explora26/tablet_sensor_board/power_button/docs/pcb_3d_iso.png

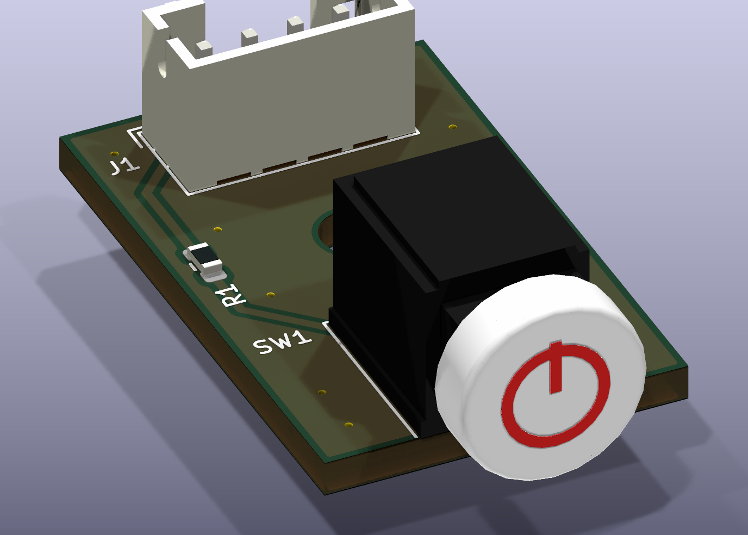
power_button/docs/pcb_3d_iso.png
