explora26/tablet_sensor_board/power_button/docs/pcb_3d_top.png

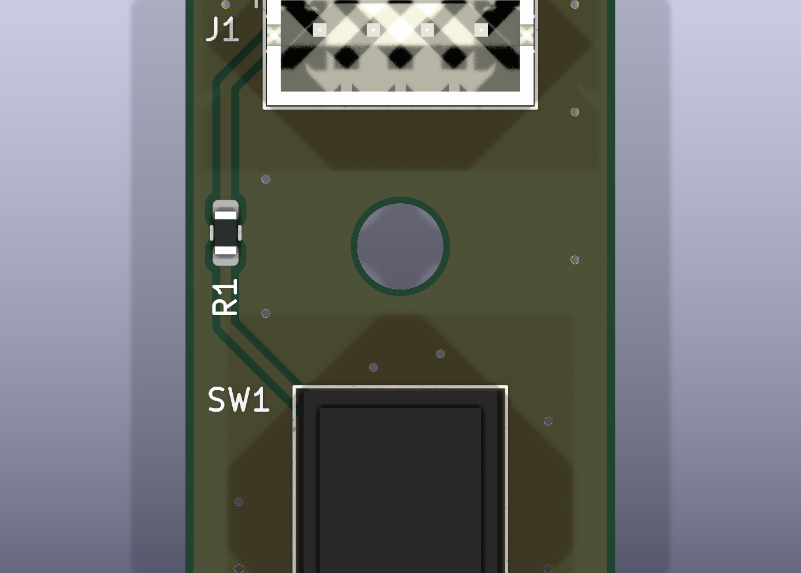
power_button/docs/pcb_3d_top.png
