explora26/tablet_sensor_board/docs/pcb_front.png

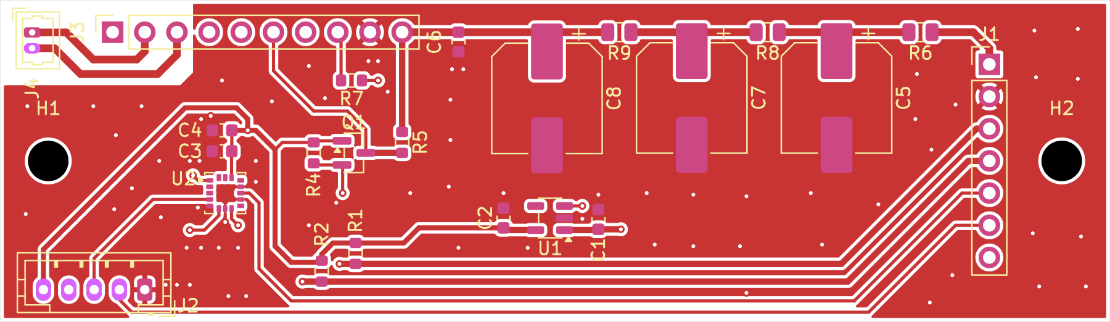
docs/pcb_front.png
