explora26/tablet_sensor_board/fab/bom.csv

Designator | Qty | Value | Package | Manufacturer | MPN | LCSC | Assembly | Status | Notes
U2 | 1 | LIS3DH | LGA-16 3x3mm | ST | LIS3DHTR | C15134 | SMT | confirmed | 3-axis accelerometer (I2C addr 0x18)
U1 | 1 | TLV75530 | SOT-23-5 | TI | TLV75530PDBVR | C507268 | SMT | confirmed | 500mA LDO 3.0V
Q1 | 1 | BSS138 | SOT-23 | Diodes | BSS138-7-F | C40912 | SMT | confirmed | RFID TX level shifter
C5 C7 C8 | 3 | 1000uF 10V | SMD 8x10.2mm | Panasonic | EEE-FT1A102AP | C278408 | SMT | confirmed | RFID supply RC filter; polarized
C1 C2 | 2 | 1uF 16V X7R | 0603 | YAGEO | CC0603KRX7R7BB105 | C106248 | SMT | confirmed | LDO input/output
C3 C6 | 2 | 100nF 50V X7R | 0603 | YAGEO | CC0603KRX7R9BB104 | C14663 | SMT | confirmed | LIS3DH VDD / RFID HF decoupling
C4 | 1 | 10uF 10V X5R | 0603 | Samsung | CL10A106KP8NNNC | C19702 | SMT | confirmed | LIS3DH bulk; JLC basic part
R1 R2 | 2 | 4.7k 1% | 0603 | YAGEO | RC0603FR-074K7L | C99782 | SMT | confirmed | I2C pull-ups to 3.0V
R4 R5 R7 | 3 | 10k 1% | 0603 | YAGEO | RC0603FR-0710KL | C98220 | SMT | confirmed | Level shifter pull-ups / WL-125 RESET pull-up
R6 | 1 | 4.7R | 0805 | YAGEO | (per LCSC C137423) | C137423 | SMT | user-selected | RFID RC filter stage 1; verify the LCSC page shows 4.7 ohm
R8 R9 | 2 | 1R | 0805 | YAGEO | (per LCSC C131397) | C131397 | SMT | user-selected | RFID RC filter stages 2-3; verify the LCSC page shows 1 ohm
J2 | 1 | JST PH 5P vertical | 2.0mm THT | JST | B5B-PH-K-S(LF)(SN) | C157993 | hand solder | confirmed | BQ25798 charger board
J1 | 1 | 1x07 pin header | 2.54mm THT | any |  |  | hand solder |  | NanoPC-T4 interface
J3 | 1 | 1x10 pin socket | 2.54mm THT | any |  |  | hand solder |  | WL-125 socket (pin 1 = key)
J4 | 1 | PicoBlade 2P vertical | 1.25mm THT | Molex | 53047-0210 |  | hand solder | find LCSC | RFID antenna coil
