explora26/tablet_sensor_board/power_button/3d/power_button_board.step

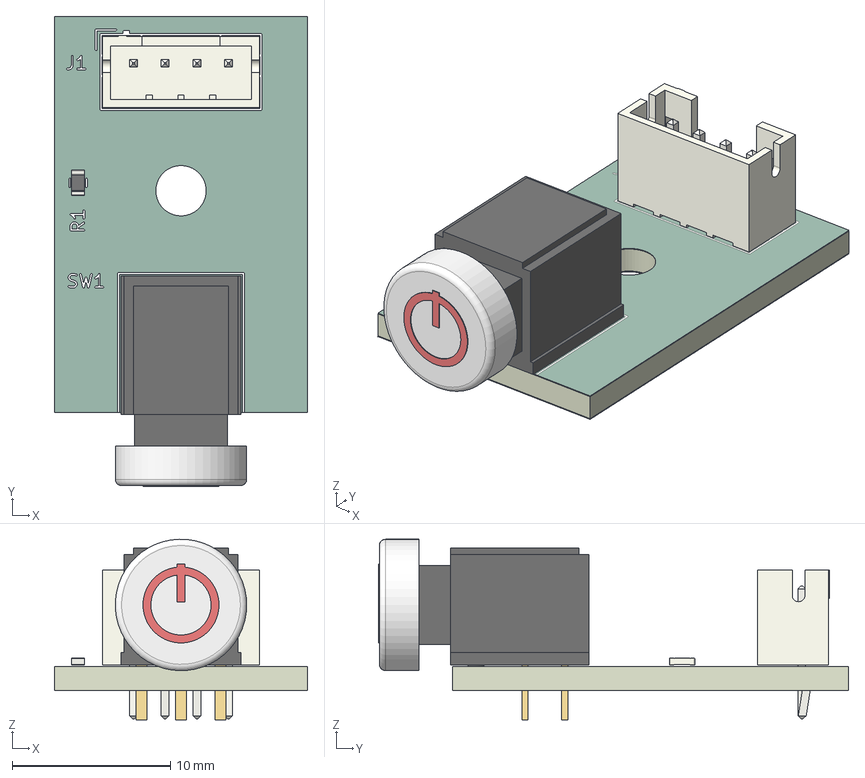
[picture p4: CAD file, 2026-10-19]
power_button/3d/power_button_board.step
16.0 x 29.7 x 11.4 mm
housing
cap
symbol
pins
R_0603_1608Metric
JST_B4B_PH_K
power_button_silkscreen x 2
power_button_soldermask x 2
power_button_PCB
