explora26/tablet_sensor_board/power_button/3d/KRHRO_K6-6277D.step

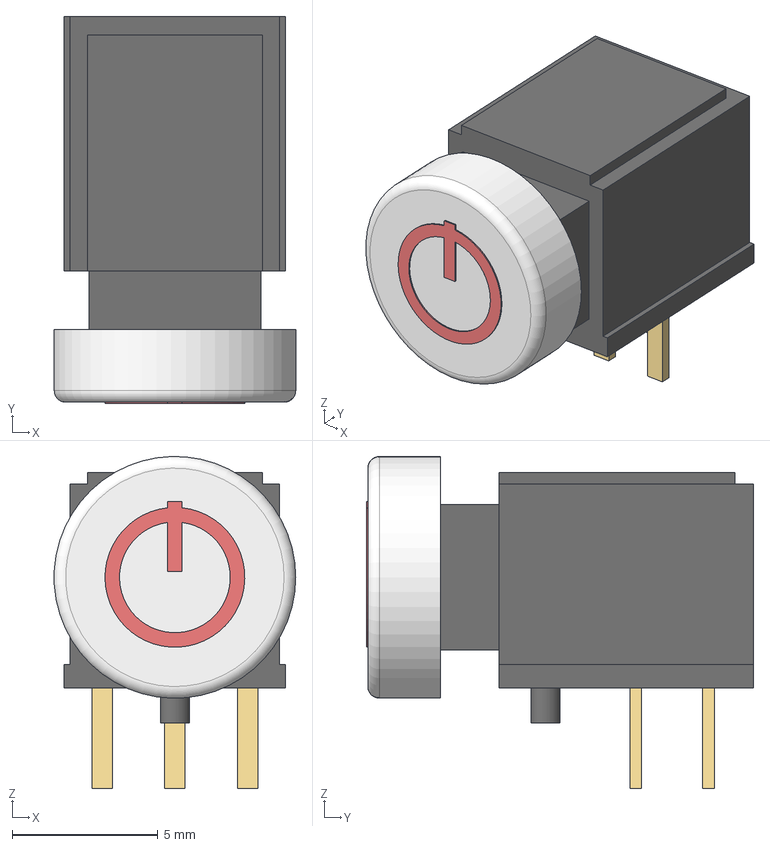
[picture p5: CAD file, 2026-10-19]
power_button/3d/KRHRO_K6-6277D.step
8.29 x 13.3 x 11.4 mm
housing
cap
symbol
pins
