explora26/tablet_sensor_board/docs/schematic.pdf

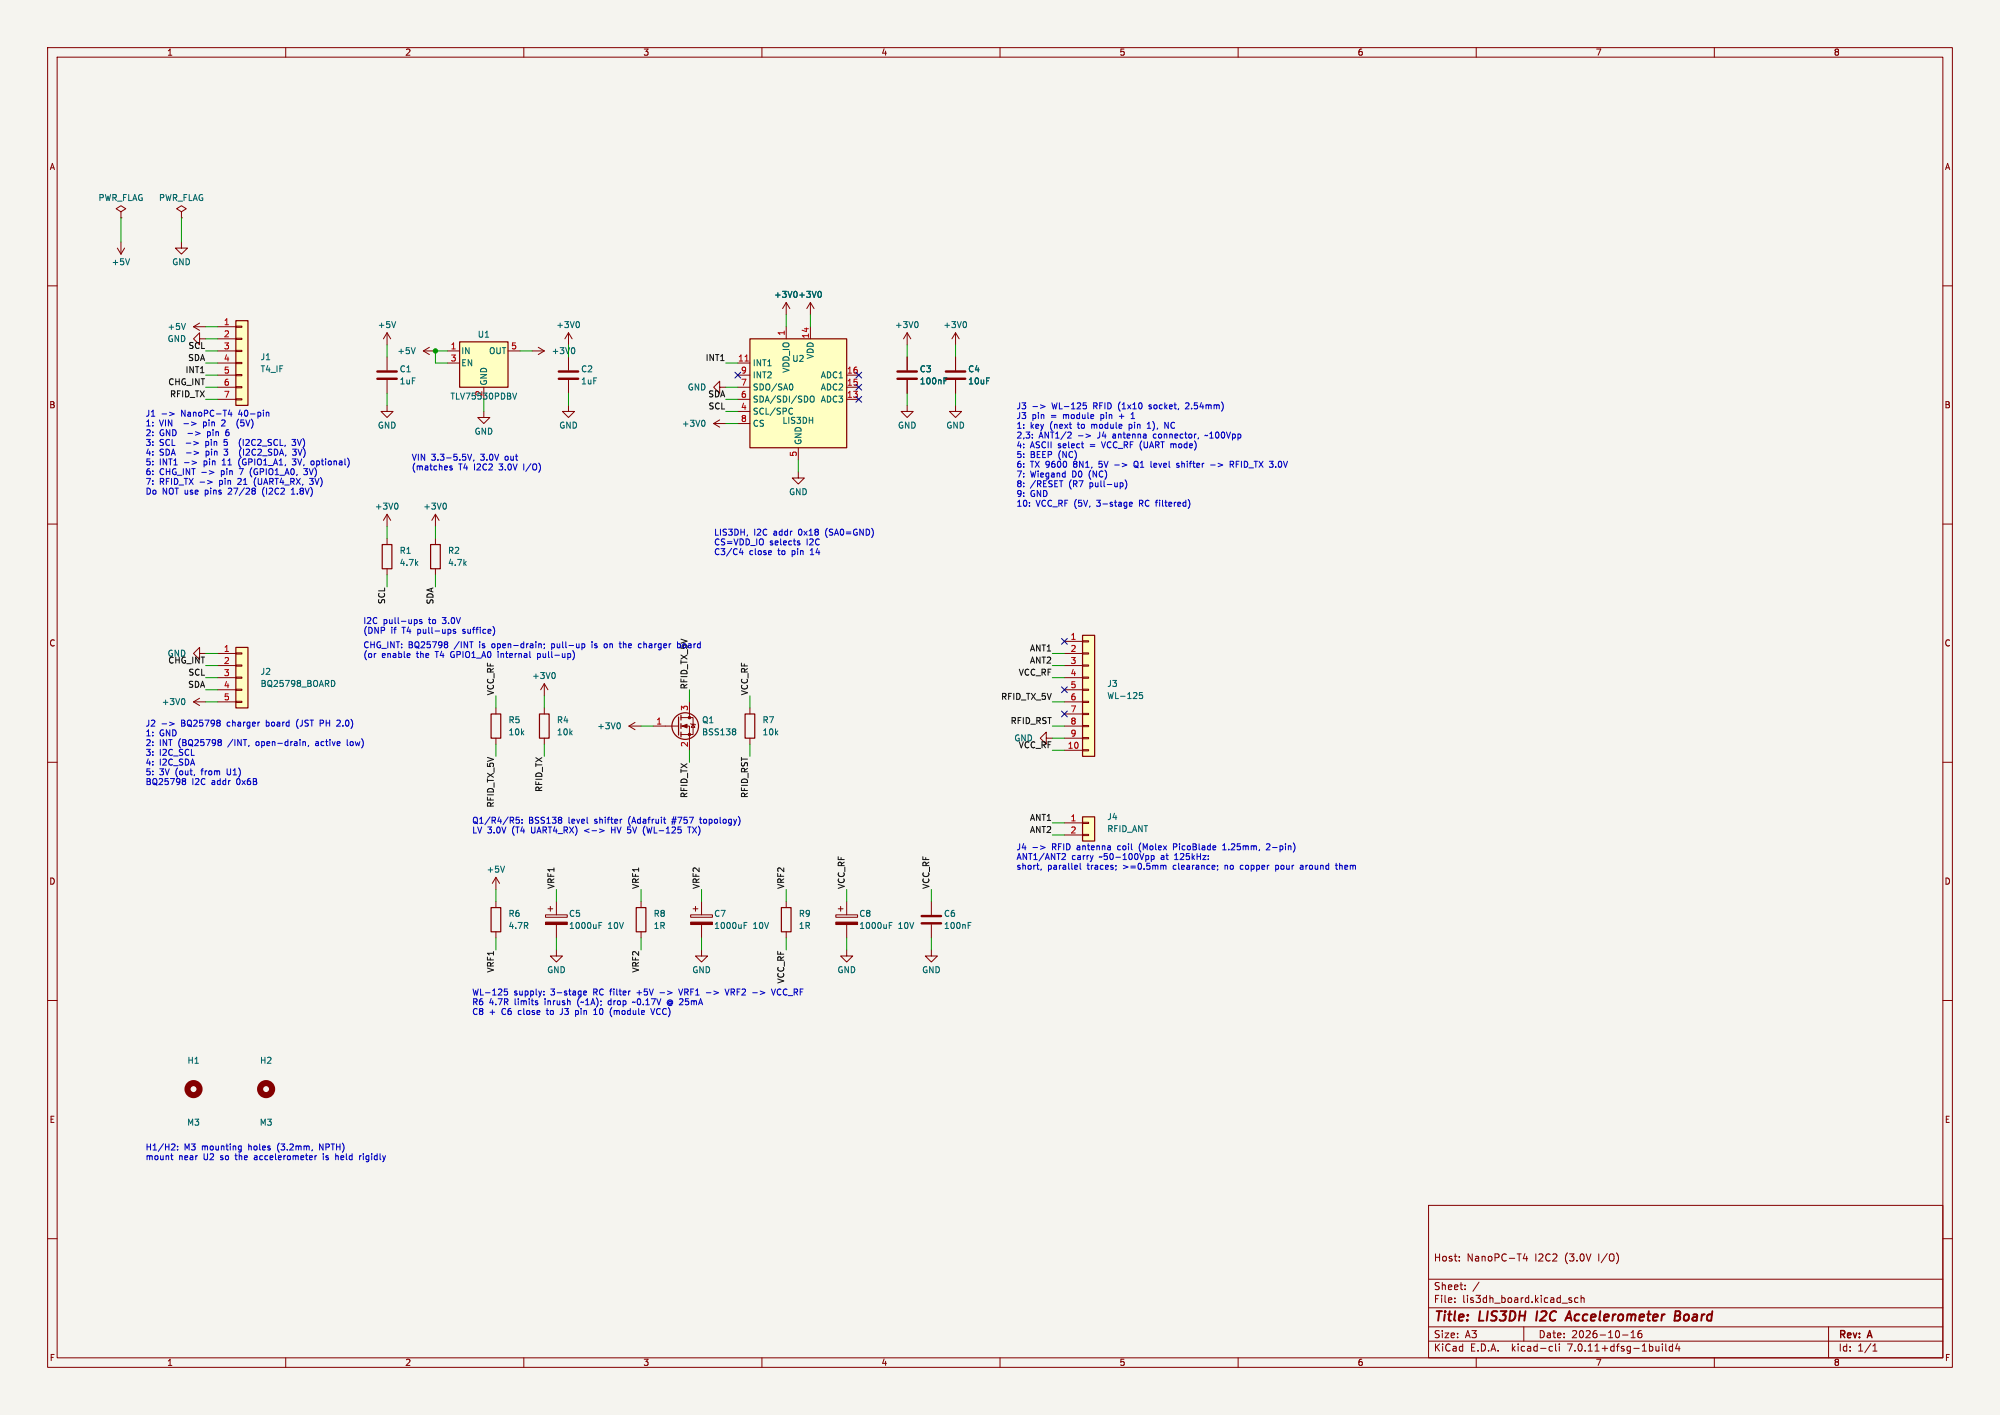
[picture p6: page 1]

2 EN 3 OUT 5 U1 TLV75530PDBV GND GND GND GND

5 SDA/SDI/SDO 6 SDO/SA0 7 CS 8
LIS3DH GND

1: key (next to module pin 1), NC

7: Wiegand D0 (NC) 8: /RESET (R7 pull-up) 9: GND

Id: 1/1 Title: LIS3DH I2C Accelerometer Board
