explora26/tablet_sensor_board/power_button/docs/schematic.pdf

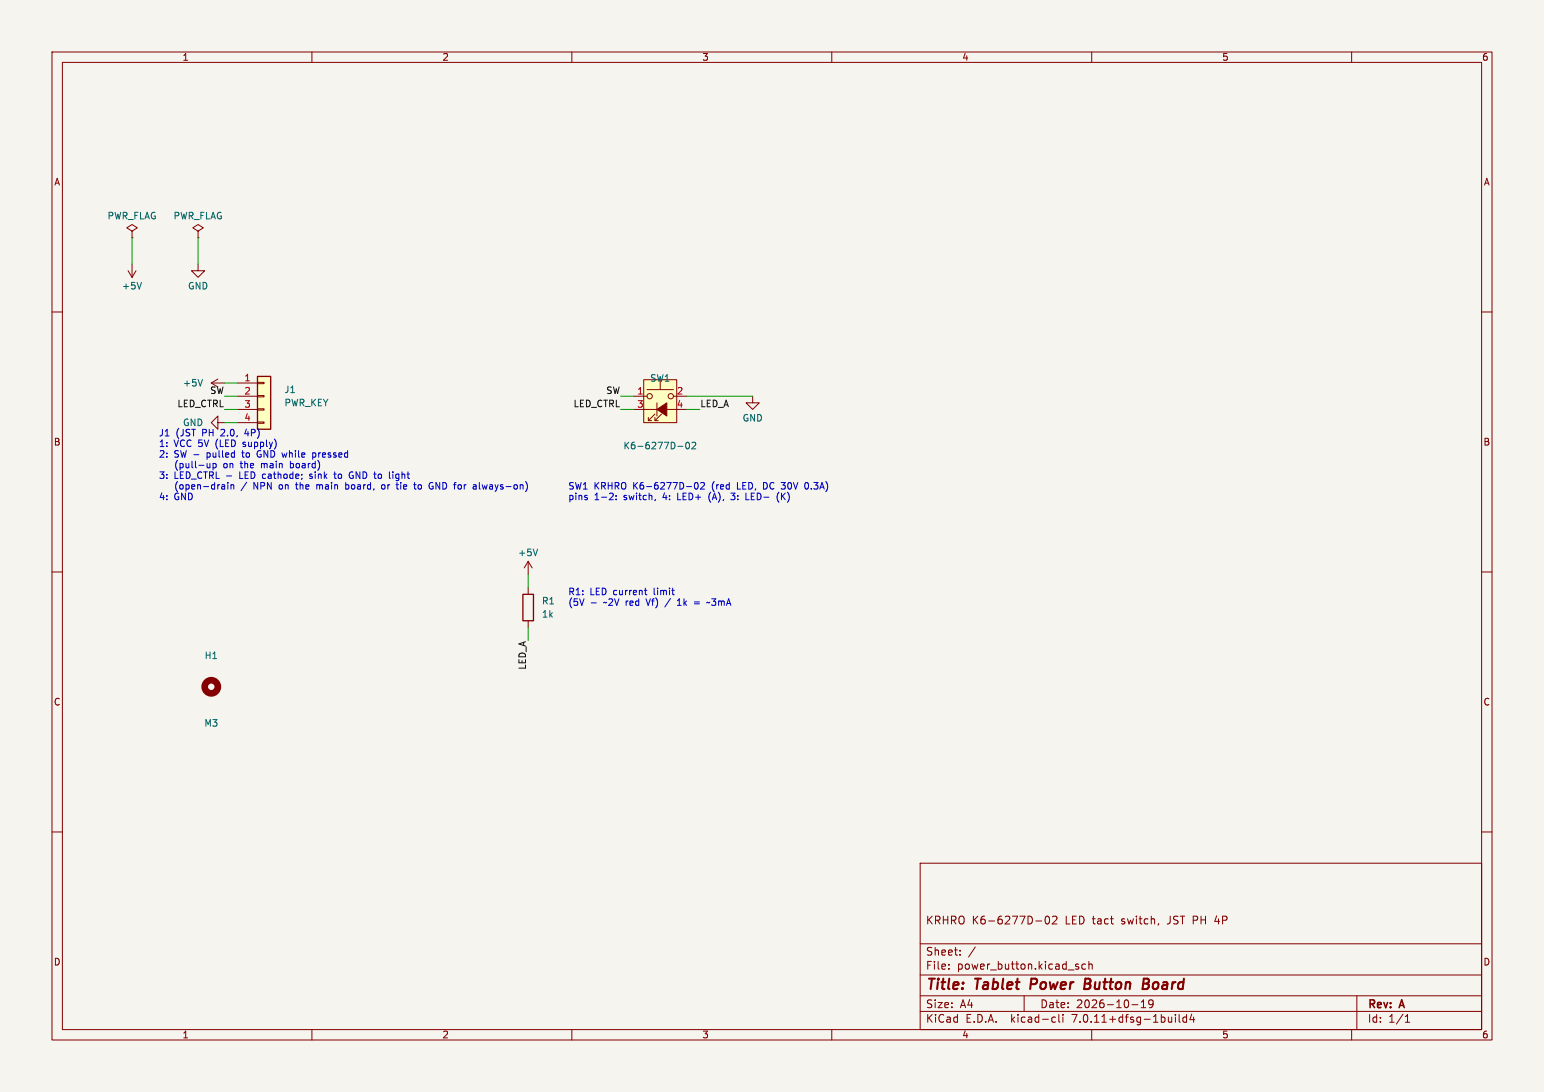
[picture p7: page 1]

H1 M3 GND
J1 (JST PH 2.0, 4P) 1: VCC 5V (LED supply) 2: SW - pulled to GND while pressed

R1: LED current limit (5V - ~2V red Vf) / 1k = ~3mA

Id: 1/1 Title: Tablet Power Button Board
