explora26/tablet_sensor_board/power_button/power_button.kicad_pcb

## KiCad design power_button/power_button.kicad_pcb (2026-10-19)

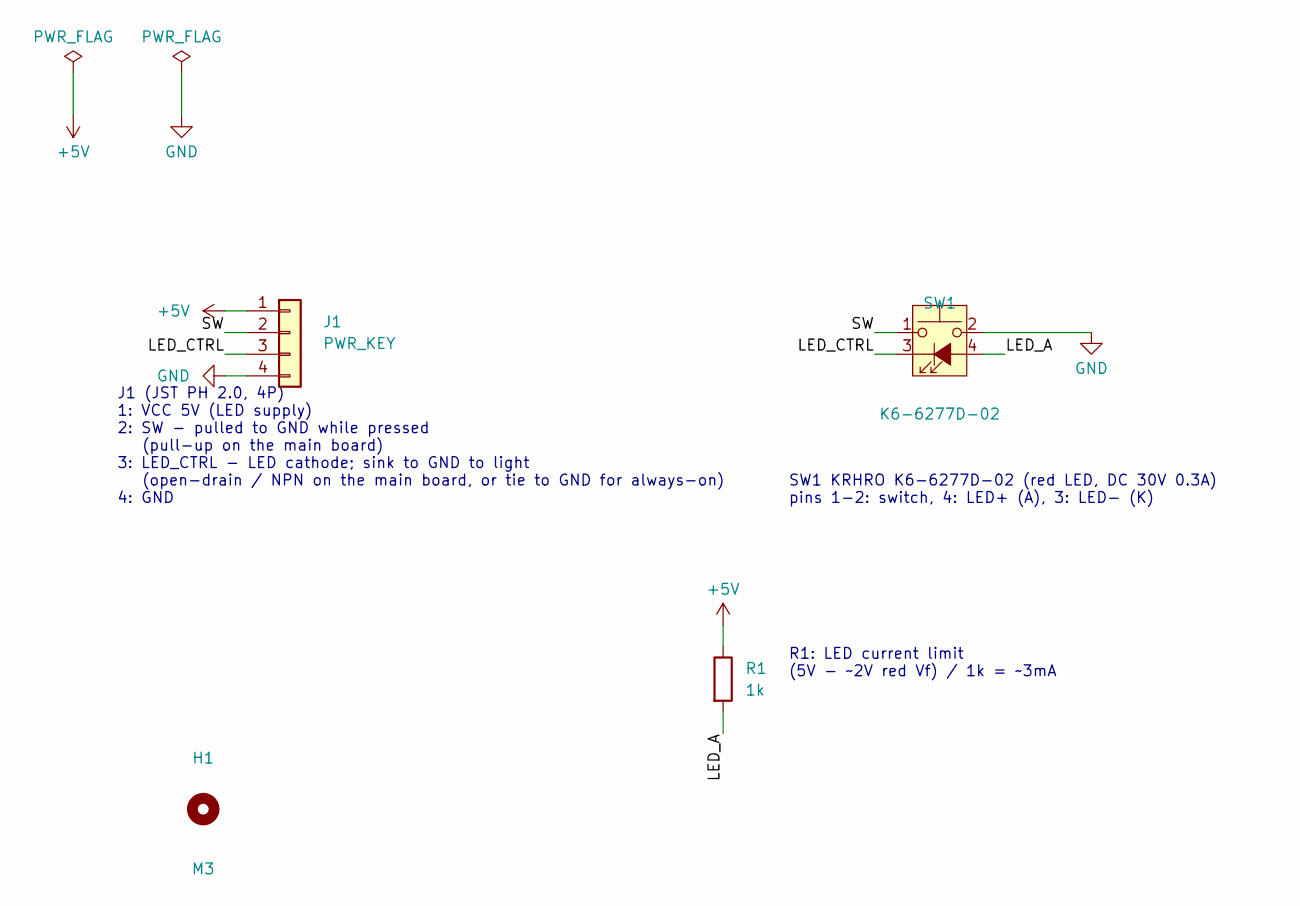
[picture p8: schematic power_button.kicad_sch, Tablet Power Button Board]

Parts:
H1: M3; MountingHole_3.2mm_M3
J1: PWR_KEY; JST_PH_B4B-PH-K_1x04_P2.00mm_Vertical; MPN JST B4B-PH-K-S(LF)(SN)
R1: 1k; R_0603_1608Metric; MPN YAGEO RC0603FR-071KL
SW1: K6-6277D-02; KRHRO_K6-6277D; MPN KRHRO K6-6277D-02; LCSC C693836

Connections:
+5V: J1.1, R1.1
/LED_A: R1.2, SW1.4 (A)
/LED_CTRL: J1.3, SW1.3 (K)
/SW: J1.2, SW1.1
GND: J1.4, SW1.2

Notes on the sheet:
J1 (JST PH 2.0, 4P) 1: VCC 5V (LED supply) 2: SW - pulled to GND while pressed (pull-up on the main board) 3: LED_CTRL - LED cathode; sink to GND to light (open-drain / NPN on the main board, or tie to GND for always-on) 4: GND
SW1 KRHRO K6-6277D-02 (red LED, DC 30V 0.3A) pins 1-2: switch, 4: LED+ (A), 3: LED- (K)
R1: LED current limit (5V - ~2V red Vf) / 1k = ~3mA

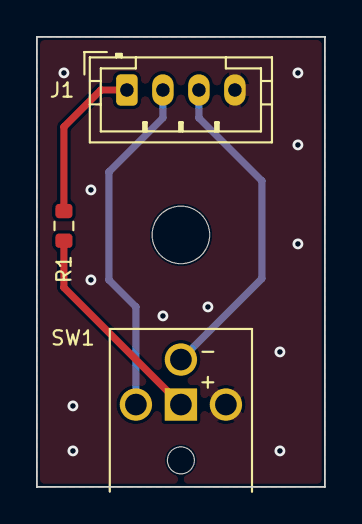
[picture p9: board power_button.kicad_pcb from above]

Board: 2 copper layers, 16.0 x 25.0 mm, 4 parts (0 on the bottom side), 5 nets.
