explora26/tablet_sensor_board/lis3dh_board.kicad_pcb

## KiCad design lis3dh_board.kicad_pcb (2026-10-17)

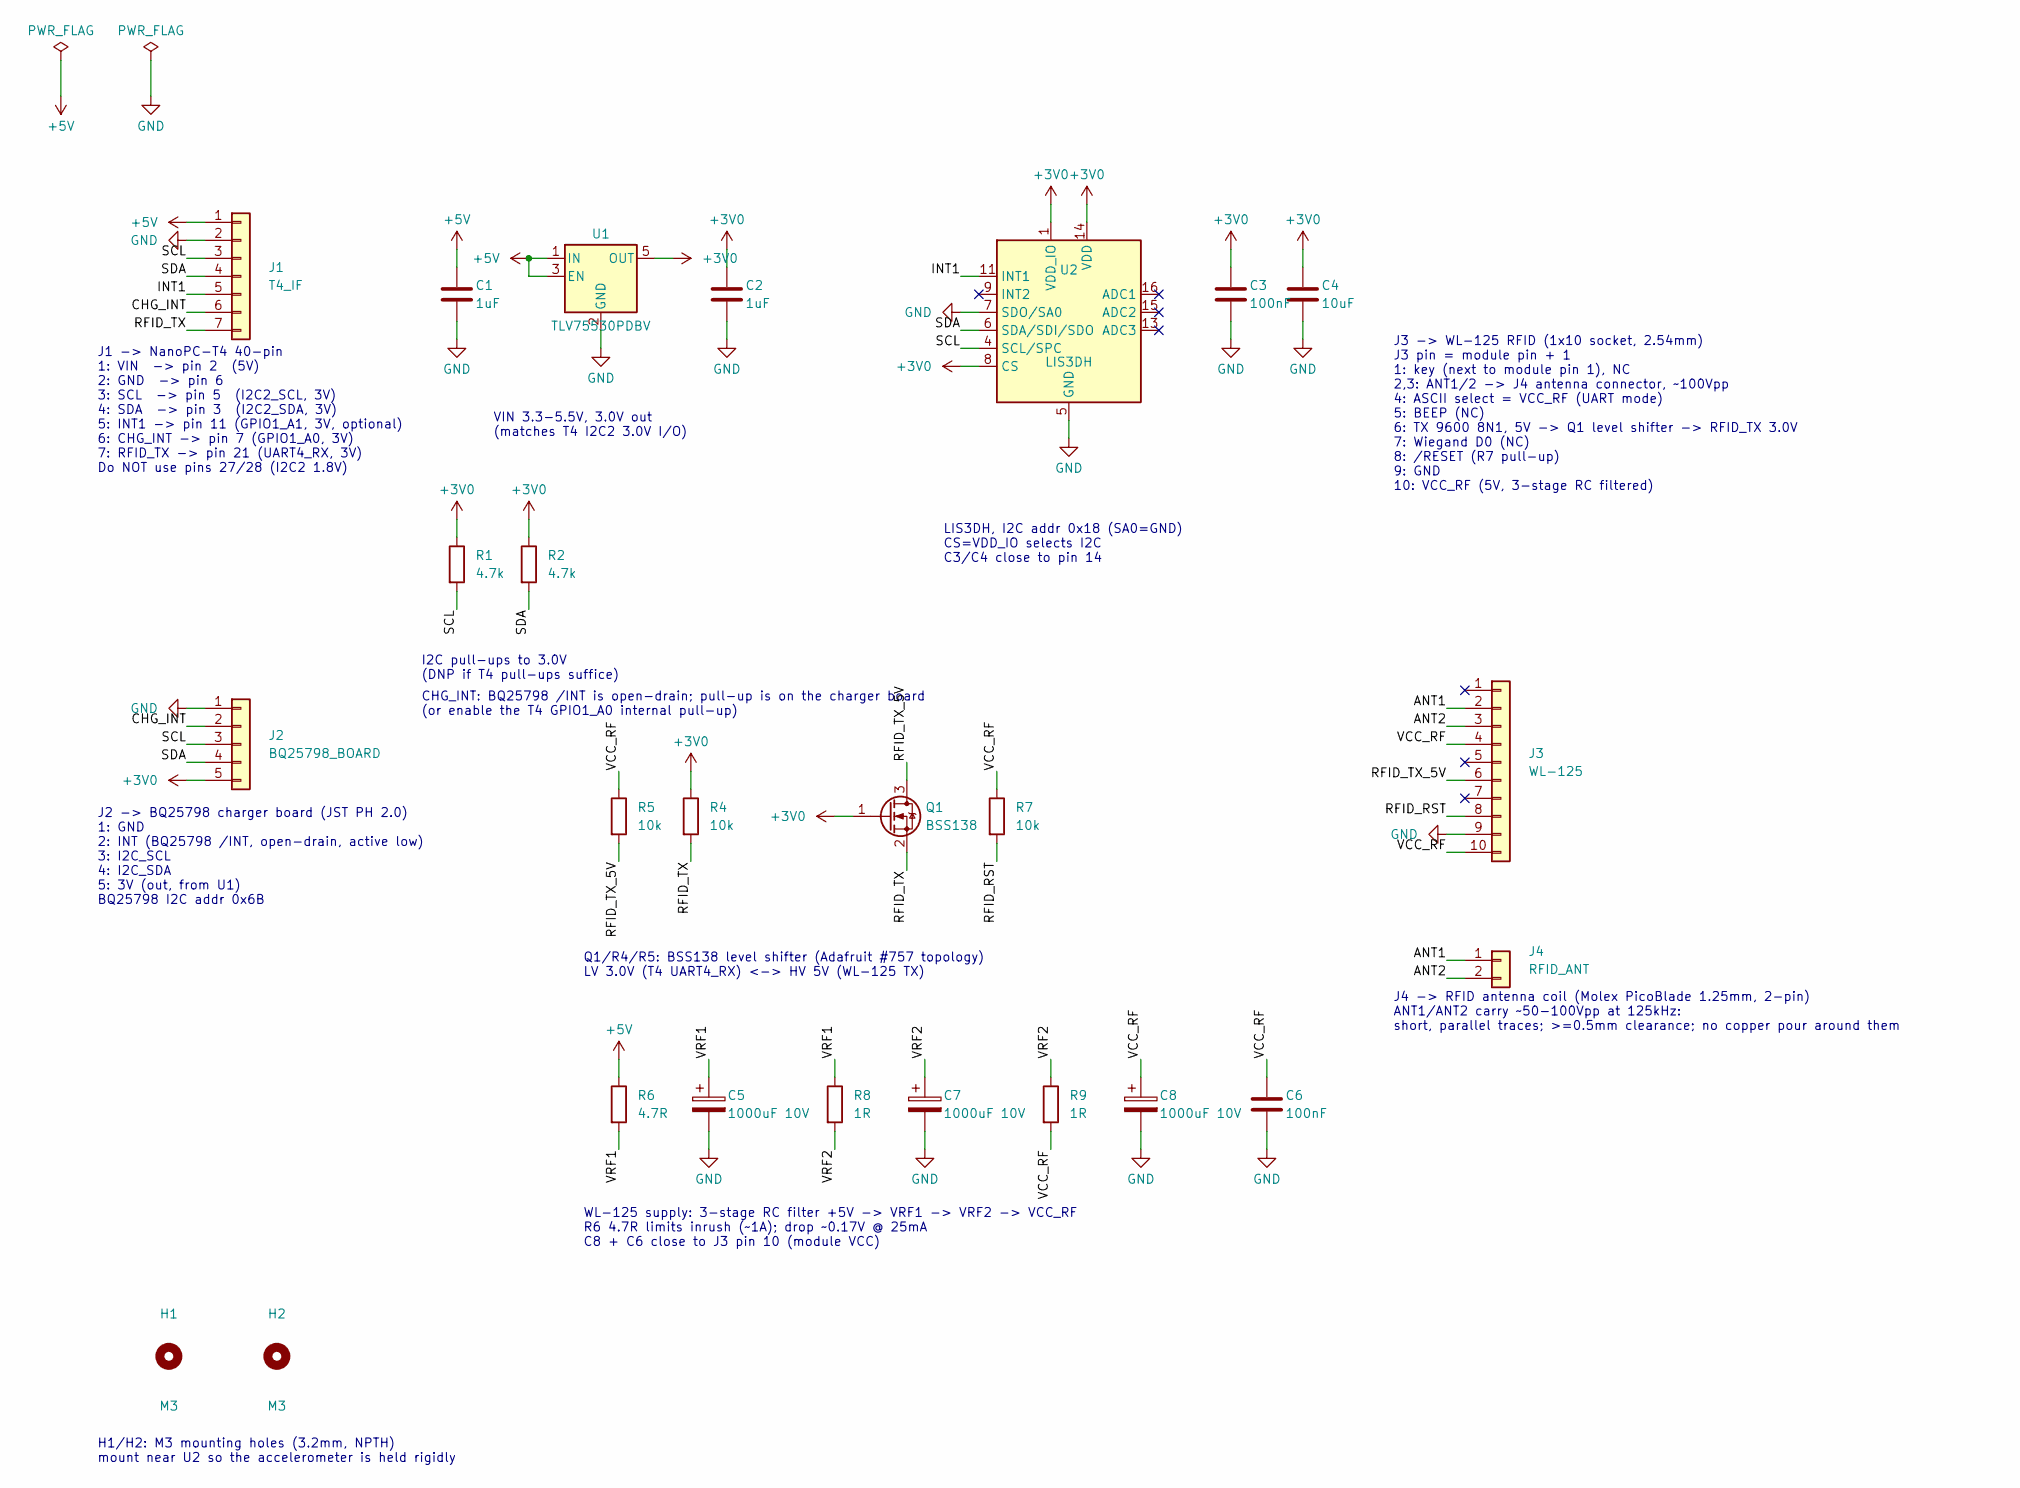
[picture p10: schematic lis3dh_board.kicad_sch, LIS3DH I2C Accelerometer Board]

Parts:
C1, C2: 1uF; C_0603_1608Metric
C3, C6: 100nF; C_0603_1608Metric
C4: 10uF; C_0603_1608Metric
C5, C7, C8: 1000uF 10V; CP_Elec_8x10.5; MPN Panasonic EEE-FT1A102AP; LCSC C278408
H1, H2: M3; MountingHole_3.2mm_M3
J1: T4_IF; PinHeader_1x07_P2.54mm_Vertical
J2: BQ25798_BOARD; JST_PH_B5B-PH-K_1x05_P2.00mm_Vertical
J3: WL-125; PinSocket_1x10_P2.54mm_Vertical
J4: RFID_ANT; Molex_PicoBlade_53047-0210_1x02_P1.25mm_Vertical; MPN Molex 53047-0210
Q1: BSS138; SOT-23
R1, R2: 4.7k; R_0603_1608Metric
R4, R5, R7: 10k; R_0603_1608Metric
R6: 4.7R; R_0805_2012Metric
R8, R9: 1R; R_0805_2012Metric
U1: TLV75530PDBV; SOT-23-5
U2: LIS3DH; LGA-16_3x3mm_P0.5mm_LayoutBorder3x5y

Connections:
+3V0: C2.1, C3.1, C4.1, J2.5, Q1.1 (G), R1.1, R2.1, R4.1, U1.5 (OUT), U2.1 (VDD_IO), U2.8 (CS), U2.14 (VDD)
+5V: C1.1, J1.1, R6.1, U1.1 (IN), U1.3 (EN)
/ANT1: J3.2, J4.1
/ANT2: J3.3, J4.2
/CHG_INT: J1.6, J2.2
/INT1: J1.5, U2.11 (INT1)
/RFID_RST: J3.8, R7.2
/RFID_TX: J1.7, Q1.2 (S), R4.2
/RFID_TX_5V: J3.6, Q1.3 (D), R5.2
/SCL: J1.3, J2.3, R1.2, U2.4 (SCL/SPC)
/SDA: J1.4, J2.4, R2.2, U2.6 (SDA/SDI/SDO)
/VCC_RF: C6.1, C8.1, J3.4, J3.10, R5.1, R7.1, R9.2
/VRF1: C5.1, R6.2, R8.1
/VRF2: C7.1, R8.2, R9.1
GND: C1.2, C2.2, C3.2, C4.2, C5.2, C6.2, C7.2, C8.2, J1.2, J2.1, J3.9, U1.2 (GND), U2.5 (GND), U2.7 (SDO/SA0), U2.10 (GND), U2.12 (GND)

Notes on the sheet:
J1 -> NanoPC-T4 40-pin 1: VIN -> pin 2 (5V) 2: GND -> pin 6 3: SCL -> pin 5 (I2C2_SCL, 3V) 4: SDA -> pin 3 (I2C2_SDA, 3V) 5: INT1 -> pin 11 (GPIO1_A1, 3V, optional) 6: CHG_INT -> pin 7 (GPIO1_A0, 3V) 7: RFID_TX -> pin 21 (UART4_RX, 3V) Do NOT use pins 27/28 (I2C2 1.8V)
VIN 3.3-5.5V, 3.0V out (matches T4 I2C2 3.0V I/O)
I2C pull-ups to 3.0V (DNP if T4 pull-ups suffice)
J2 -> BQ25798 charger board (JST PH 2.0) 1: GND 2: INT (BQ25798 /INT, open-drain, active low) 3: I2C_SCL 4: I2C_SDA 5: 3V (out, from U1) BQ25798 I2C addr 0x6B
CHG_INT: BQ25798 /INT is open-drain; pull-up is on the charger board (or enable the T4 GPIO1_A0 internal pull-up)
J3 -> WL-125 RFID (1x10 socket, 2.54mm) J3 pin = module pin + 1 1: key (next to module pin 1), NC 2,3: ANT1/2 -> J4 antenna connector, ~100Vpp 4: ASCII select = VCC_RF (UART mode) 5: BEEP (NC) 6: TX 9600 8N1, 5V -> Q1 level shifter -> RFID_TX 3.0V 7: Wiegand D0 (NC) 8: /RESET (R7 pull-up) 9: GND 10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
J4 -> RFID antenna coil (Molex PicoBlade 1.25mm, 2-pin) ANT1/ANT2 carry ~50-100Vpp at 125kHz: short, parallel traces; >=0.5mm clearance; no copper pour around them
Q1/R4/R5: BSS138 level shifter (Adafruit #757 topology) LV 3.0V (T4 UART4_RX) <-> HV 5V (WL-125 TX)
WL-125 supply: 3-stage RC filter +5V -> VRF1 -> VRF2 -> VCC_RF R6 4.7R limits inrush (~1A); drop ~0.17V @ 25mA C8 + C6 close to J3 pin 10 (module VCC)
LIS3DH, I2C addr 0x18 (SA0=GND) CS=VDD_IO selects I2C C3/C4 close to pin 14
H1/H2: M3 mounting holes (3.2mm, NPTH) mount near U2 so the accelerometer is held rigidly

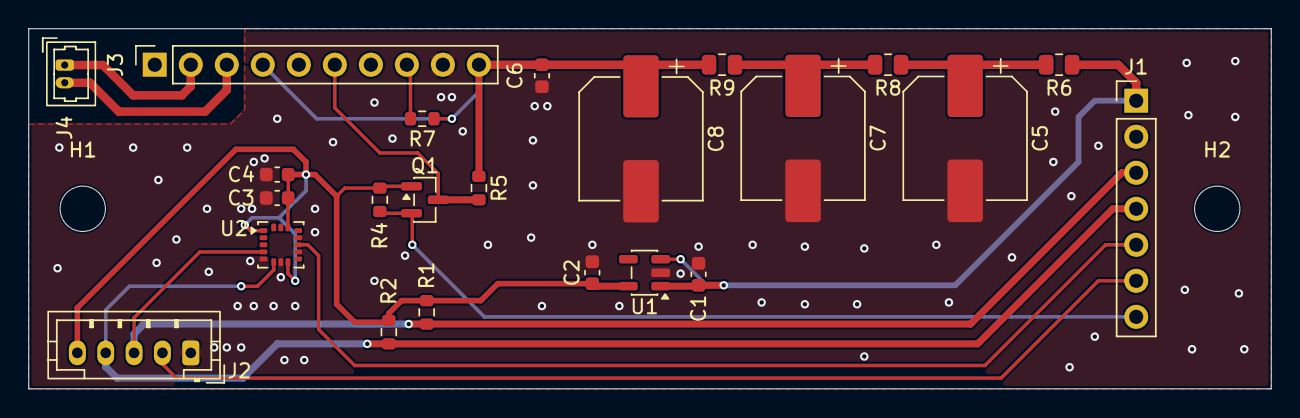
[picture p11: board lis3dh_board.kicad_pcb from above]

Board: 2 copper layers, 87.6 x 25.4 mm, 25 parts (0 on the bottom side), 15 nets.
