explora26/tablet_sensor_board/(commit log)

2026-10-17 Add LIS3DH sensor board schematic for NanoPC-T4
    LIS3DH 3-axis accelerometer on NanoPC-T4 I2C2 (3.0V I/O), with a
    TLV75530 LDO providing 3.0V and a JST PH 2.0 connector to the BQ25798
    charger board (3V, SDA, SCL, INT, GND). Layout is pending until the
    board size is decided.
    Claude-Session: https://claude.ai/code/session_012K15v8QNdkAoa4NiCNiWuG
    [bom.csv, lis3dh_board.kicad_sch]
2026-10-17 Reverse J2 pin order for the charger board connector
    J2 (JST PH 2.0 to the BQ25798 board) is now 1 GND, 2 INT, 3 SCL,
    4 SDA, 5 3V. Nets are unchanged; only the pin numbering is reversed.
    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
    [lis3dh_board.kicad_sch]
2026-10-17 Add WL-125 125kHz RFID module socket
    J3 is a 1x10 socket for the WL-125 (module pins 1-9, pin 10 is the
    polarization key). The module runs from a filtered 5V rail (2.2R +
    1000uF + 100nF, as its datasheet asks for clean power), pin 3 is tied
    high for UART output, and its 5V TX is divided down to ~3.0V and sent
    to T4 UART4_RX through new J1 pin 7. Antenna pins are left unconnected
    since the coil is soldered on the module.
    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
    [bom.csv, lis3dh_board.kicad_sch]
2026-10-17 Use a BSS138 level shifter for the WL-125 TX line
    Replace the R4/R5 resistor divider with a BSS138 bidirectional level
    shifter (Adafruit #757 topology): 10k pull-ups on the 3.0V and 5V sides,
    gate tied to 3.0V.
    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
    [bom.csv, lis3dh_board.kicad_sch]
2026-10-17 Put the WL-125 polarization key next to module pin 1
    J3 pin 1 is now the key position and module pins 1-9 map to J3 pins
    2-10, matching how the module's 10-pin header is fitted.
    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
    [bom.csv, lis3dh_board.kicad_sch]
2026-10-17 Use a 3-stage RC filter for the WL-125 supply
    +5V -> 4.7R -> 1000uF -> 1R -> 1000uF -> 1R -> 1000uF + 100nF ->
    VCC_RF, following the WL-125 datasheet appendix. The first resistor is
    4.7R to keep the inrush into 3 x 1000uF around 1A, and the 100nF covers
    frequencies where the electrolytics stop working. Sheet moved to A3 to
    fit the filter.
    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
    [bom.csv, lis3dh_board.kicad_sch]
2026-10-17 Use Panasonic EEE-FT1A102AP for the RFID filter capacitors
    C5/C7/C8 move from 10mm radial THT to SMD 8x10.2mm (CP_Elec_8x10.5),
    with MPN and LCSC part number (C278408) set on the symbols and in the
    BOM. EEE-FK1A102P is noted as a fallback; it needs the 10x10.5 footprint.
    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
    [bom.csv, lis3dh_board.kicad_sch]
2026-10-17 Add PicoBlade connector for the RFID antenna coil
    The 125kHz antenna coil now plugs into J4 (Molex PicoBlade 53047-0210,
    1.25mm 2-pin) and is routed to the WL-125 ANT1/ANT2 pins (J3 pins 2-3)
    instead of being soldered to the module. Layout notes cover the
    ~100Vpp on these traces.
    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
    [bom.csv, lis3dh_board.kicad_sch]
2026-10-17 Add two M3 mounting holes
    H1/H2 use MountingHole_3.2mm_M3 (non-plated) and are excluded from the
    BOM. Placement is left for layout, near the accelerometer.
    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
    [lis3dh_board.kicad_sch]
2026-10-17 Add PCB file
    [lis3dh_board.kicad_pcb]
2026-10-17 Route the PCB and remove R3
    - Remove R3 (CHG_INT pull-up); the pull-up lives on the charger board.
    - Route the user's placement with Freerouting: netclasses Default
    (0.25mm), Power (+5V/VRF1/VRF2/VCC_RF, 0.4mm) and ANT (0.3mm, 0.4mm
    clearance), B.Cu GND plane, F.Cu GND pour plus 6 stitching vias.
    KiCad 10 DRC: no errors, 0 unconnected, schematic parity clean.
    - Export Gerbers, drill and position files; add scripts/route.sh and
    route_pcb.py for re-routing; drop the obsolete gen_pcb.py.
    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
    [bom.csv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]
2026-10-17 Route the PCB
    [lis3dh_board.kicad_pcb]
2026-10-17 Show the R2 reference on the silkscreen
    The R2 reference was hidden; make it visible and place it above the part
    (same offset as R1) so it clears the pads.
    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
    [lis3dh_board.kicad_pcb]
2026-10-17 Route rfid_tx
    [lis3dh_board.kicad_pcb]
2026-10-17 Regenerate fab outputs for the updated layout
    Board is now 87.6 x 25.4 mm with RFID_TX routed. KiCad 10 DRC: no
    errors, 0 unconnected, schematic parity clean. Re-export Gerbers,
    drill, position file and the front preview.
    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
    [lis3dh_board-B_Cu.gbl, lis3dh_board-B_Mask.gbs, lis3dh_board-B_Paste.gbp, lis3dh_board-B_Silkscreen.gbo, lis3dh_board-Edge_Cuts.gm1, lis3dh_board-F_Cu.gtl, lis3dh_board-F_Mask.gts, lis3dh_board-F_Paste.gtp]
2026-10-17 Add LCSC part numbers and JLC assembly files
    - fab/bom.csv: manufacturer, MPN, LCSC number, assembly method and
    verification status per line; resistors and MLCCs are YAGEO.
    - fab/jlc_bom.csv and fab/jlc_cpl.csv for JLCPCB SMT assembly (SMD
    parts only; connectors are hand-soldered).
    - R6/R8/R9 (YAGEO 0805 4.7R/1R) and J4 still need LCSC numbers.
    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
    [bom.csv, jlc_bom.csv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]
2026-10-17 BOM: Q1 -> C40912 (Diodes BSS138-7-F), R6 -> C137423
    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
    [bom.csv, jlc_bom.csv]
2026-10-17 BOM: R8/R9 -> C131397
    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
    [bom.csv, jlc_bom.csv]
2026-10-17 BOM: C4 -> C19702 (Samsung CL10A106KP8NNNC)
    The YAGEO 10uF 0603 options were out of stock; C19702 is a JLC basic part.
    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
    [bom.csv, jlc_bom.csv]
2026-10-19 Add the tablet power button board
    New power_button/ KiCad project: KRHRO K6-6277D-02 right-angle LED tact
    switch (red), 1k LED current limit, JST PH 4P (VCC / SW / LED_CTRL /
    GND) and an M3 hole on a 24 x 20 mm two-layer board. Includes a custom
    footprint drawn from the KRHRO drawing, a CadQuery STEP model of the
    switch, the full board STEP for mechanical fit, and fab outputs.
    KiCad 10 ERC/DRC clean.
    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
    [KRHRO_K6-6277D.step, bom.csv, positions.csv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]
2026-10-19 Power button: regenerate fab outputs and 3D for the new layout
    Board is now 16 x 25 mm. KiCad 10 DRC: 0 unconnected, schematic parity
    clean (only two silk-clipped-by-edge warnings on the switch outline).
    Re-export Gerbers, drill, position file, board STEP and 3D previews.
    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
    [positions.csv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]
